hhautomatizacion/sec-challenge/README.md

<br/>
<p align="center">
  
</p>
<br/>

# sec-challenge

## Fecha
* 2014

## Descripcion del proyecto
* Control de secadora industrial challenge

## Herramientas utilizadas
* KGL_WIN version 3.66
* DopSoft version 1.01.08

## Modelos PLC, etc
* PLC LS Master K 120S K7M-DR40U
* HMI Delta DOP B05S111
* Modulo Analogo G7F-ADHA

## Autores
* <a href="http://www.github.com/emmanuel156">emmanuel156</a> 
* <a href="http://www.github.com/pedrohermon">pedrohermon</a> 

## Comentarios
* Ninguno

## Contenido
* Carpeta de Diagramas
	* Diagramas del proyecto
		* Diagramas electricos
		* Diagramas de bloques
		* Dibujos
* Carpeta de Documentos
	* Documentos pensados para el usuario final
		* Manuales de usuario
		* Manuales de programacion
* Carpeta de Fotos
	* Fotos del proyecto antes, durante y despues del desarrollo del mismo
		* Fotos
		* Capturas de pantalla
* Carpeta de Historial
	* Documentacion del desarrollo del proyecto
		* Hojas de datos de componentes
		* Manuales de usuario de componentes
		* Documentacion de funciones, herramientas
* Carpeta de Programas
	* Programas de Computadora, PLC, etc. 
		* Codigos fuente
		* Iconos e imagenes usados en los programas
		* Archivos de configuracion de los programas
		* Programas compilados
* Carpeta de Pruebas
	* Pruebas preliminares del proyecto
		* Programas incompletos, o secciones de programas
		* Capturas de comunicacion
		* Modelos de componentes que se hayan probado

---
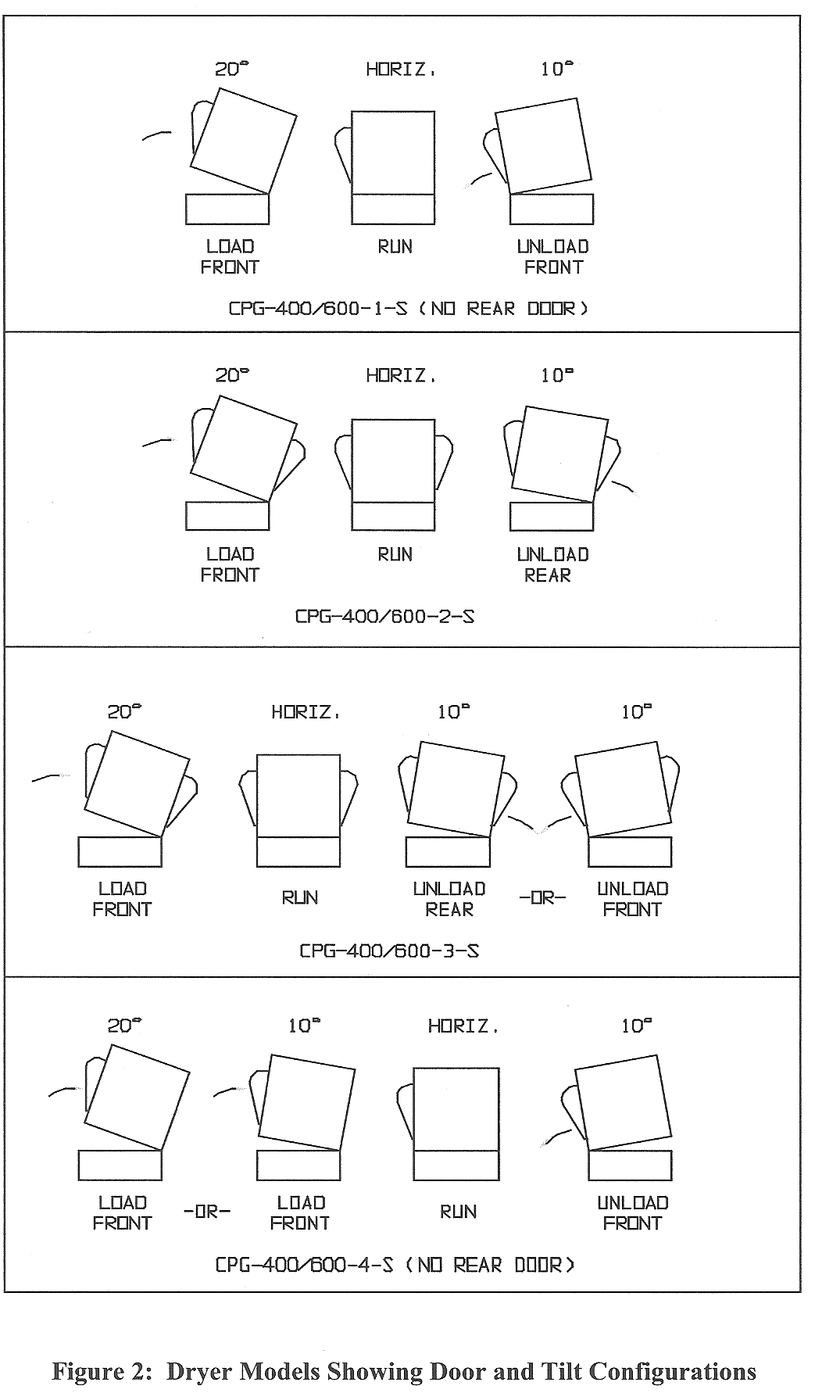
[picture p1: Diagramas/posiciones secadora.png]
posiciones secadora.png

---
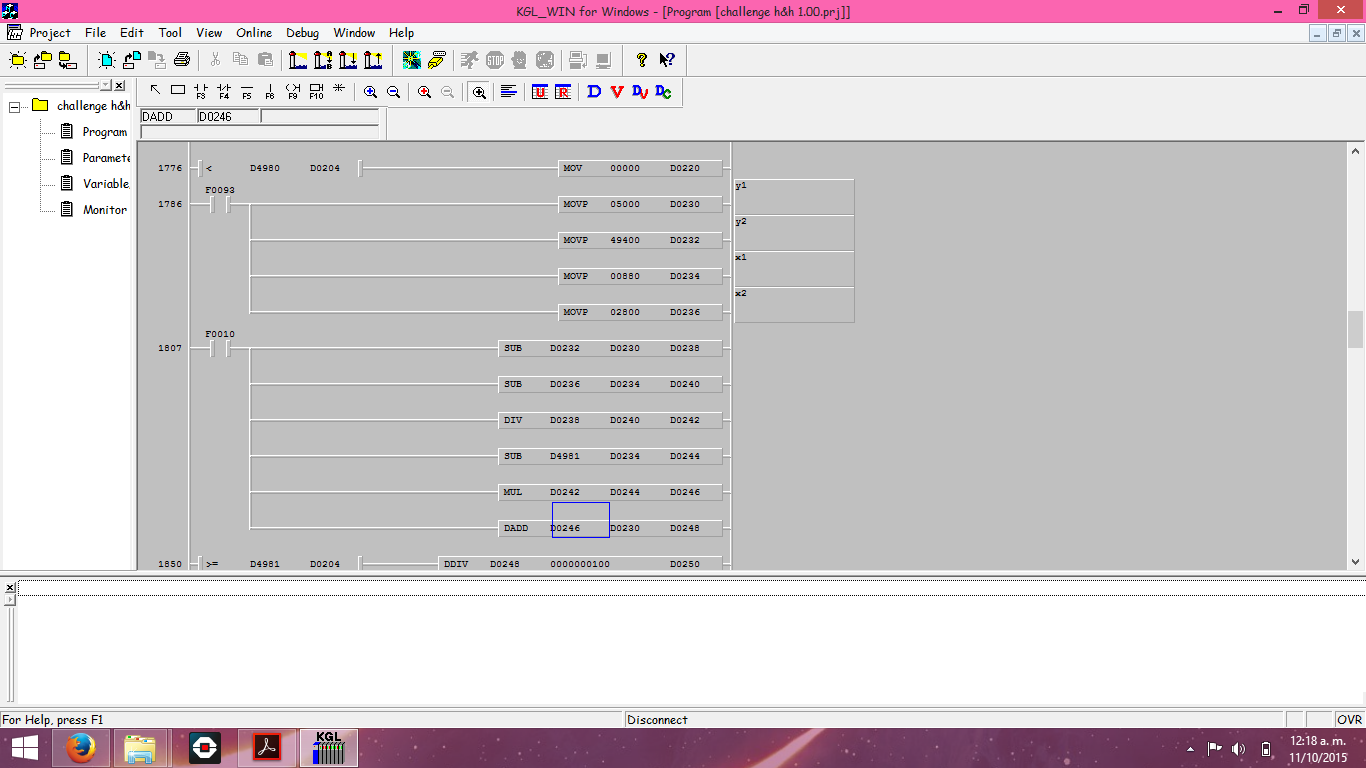
[picture p2: Fotos/Captura de pantalla 2015-10-11 00.18.39.png]
Captura de pantalla 2015-10-11 00.18.39.png

---
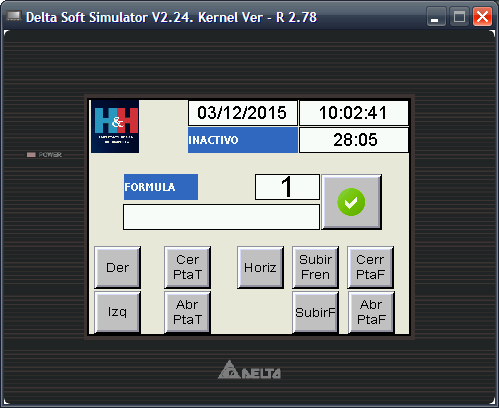
[picture p3: Fotos/Captura de pantalla 2015-12-03 10.02.41.png]
Captura de pantalla 2015-12-03 10.02.41.png

---
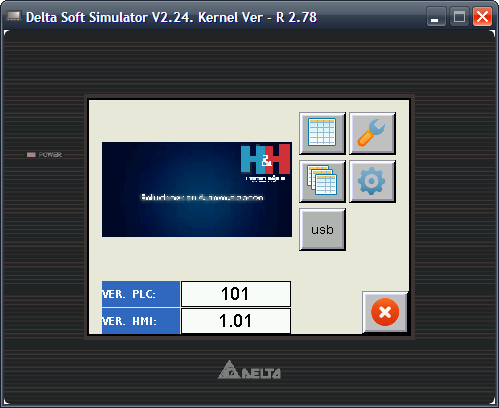
[picture p4: Fotos/Captura de pantalla 2015-12-03 14.47.43.png]
Captura de pantalla 2015-12-03 14.47.43.png

---
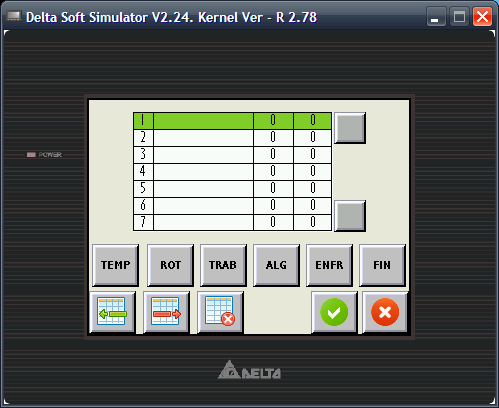
[picture p5: Fotos/Captura de pantalla 2015-12-03 14.53.48.png]
Captura de pantalla 2015-12-03 14.53.48.png

---
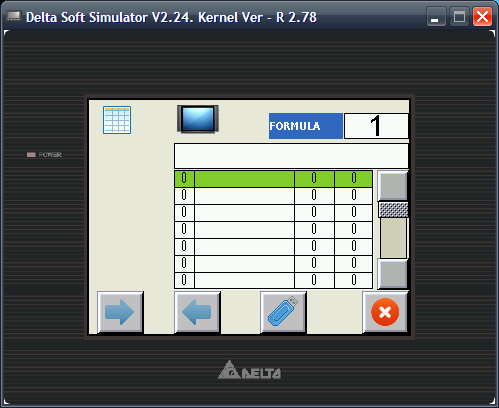
[picture p6: Fotos/Captura de pantalla 2015-12-03 14.54.10.png]
Captura de pantalla 2015-12-03 14.54.10.png

---
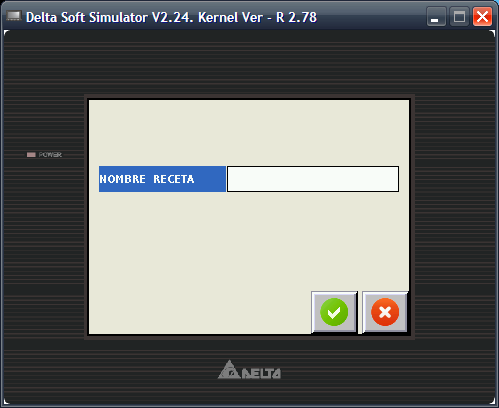
[picture p7: Fotos/Captura de pantalla 2015-12-03 14.54.32.png]
Captura de pantalla 2015-12-03 14.54.32.png

---
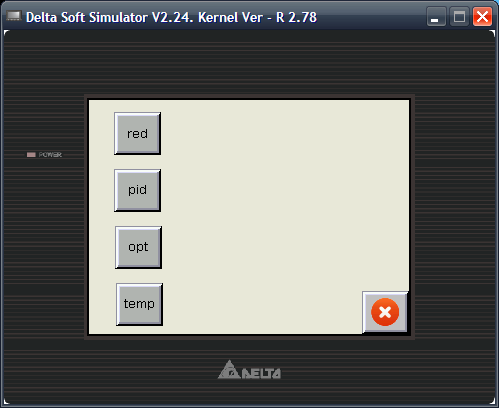
[picture p8: Fotos/Captura de pantalla 2015-12-03 14.55.09.png]
Captura de pantalla 2015-12-03 14.55.09.png

---
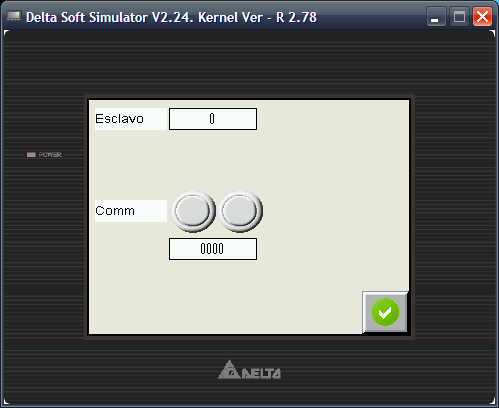
[picture p9: Fotos/Captura de pantalla 2015-12-03 14.55.13.png]
Captura de pantalla 2015-12-03 14.55.13.png

---
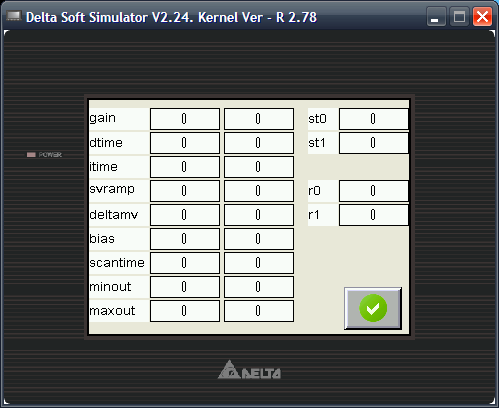
[picture p10: Fotos/Captura de pantalla 2015-12-03 14.55.18.png]
Captura de pantalla 2015-12-03 14.55.18.png

---
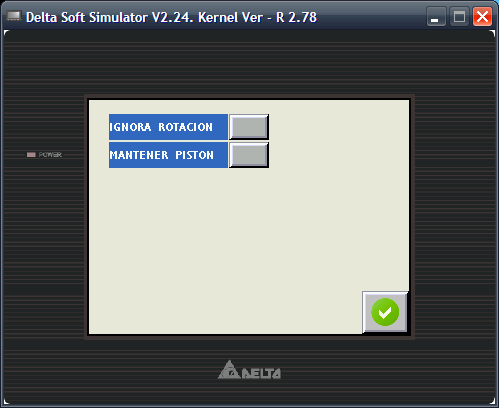
[picture p11: Fotos/Captura de pantalla 2015-12-03 14.55.22.png]
Captura de pantalla 2015-12-03 14.55.22.png

---
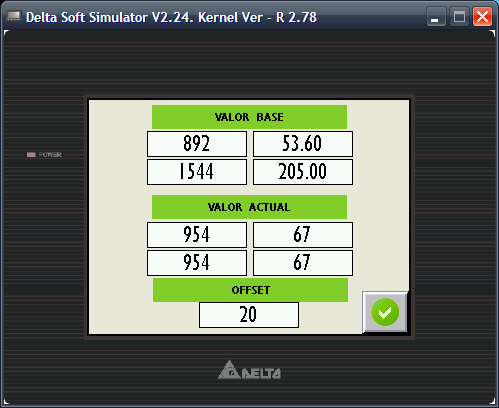
[picture p12: Fotos/Captura de pantalla 2015-12-03 14.57.56.png]
Captura de pantalla 2015-12-03 14.57.56.png

---
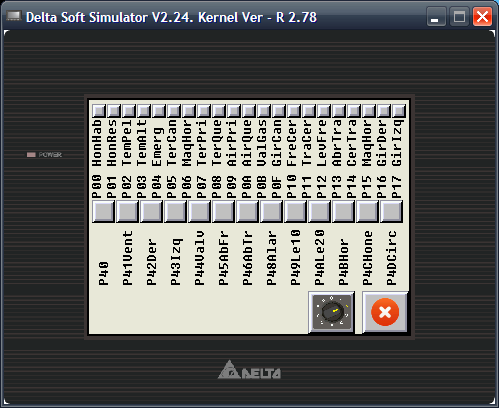
[picture p13: Fotos/Captura de pantalla 2015-12-03 14.58.13.png]
Captura de pantalla 2015-12-03 14.58.13.png

---
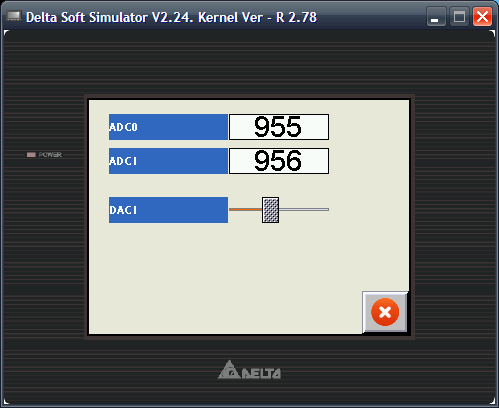
[picture p14: Fotos/Captura de pantalla 2015-12-03 14.58.29.png]
Captura de pantalla 2015-12-03 14.58.29.png

---
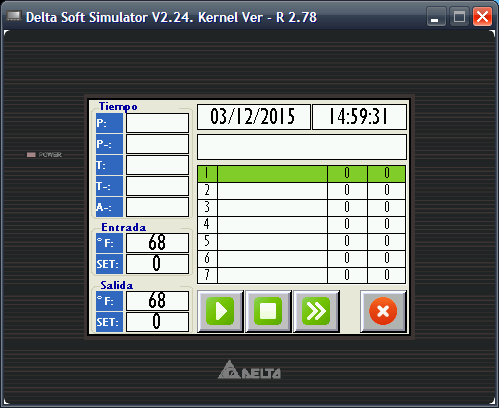
[picture p15: Fotos/Captura de pantalla 2015-12-03 14.59.31.png]
Captura de pantalla 2015-12-03 14.59.31.png

---
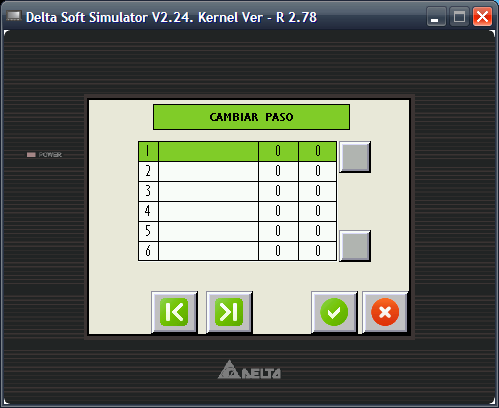
[picture p16: Fotos/Captura de pantalla 2015-12-03 14.59.51.png]
Captura de pantalla 2015-12-03 14.59.51.png

---
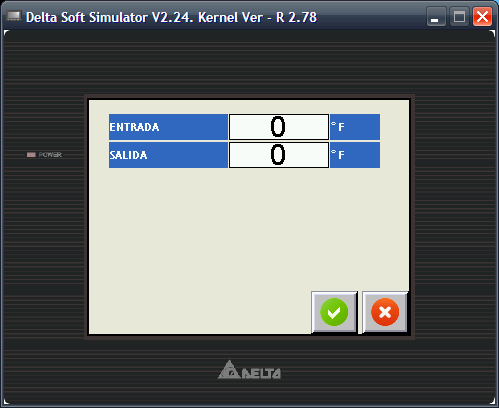
[picture p17: Fotos/Captura de pantalla 2015-12-03 15.03.30.png]
Captura de pantalla 2015-12-03 15.03.30.png

---
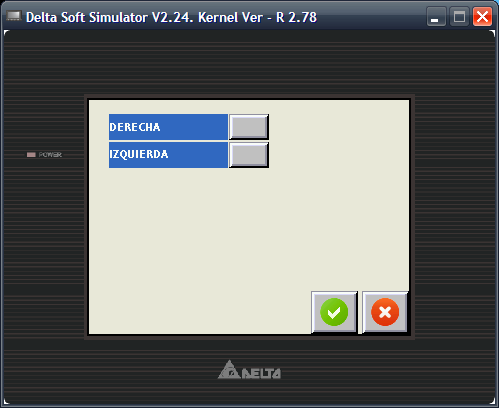
[picture p18: Fotos/Captura de pantalla 2015-12-03 15.03.36.png]
Captura de pantalla 2015-12-03 15.03.36.png

---
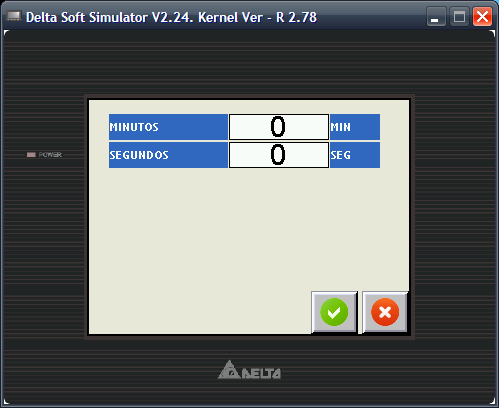
[picture p19: Fotos/Captura de pantalla 2015-12-03 15.03.47.png]
Captura de pantalla 2015-12-03 15.03.47.png

---
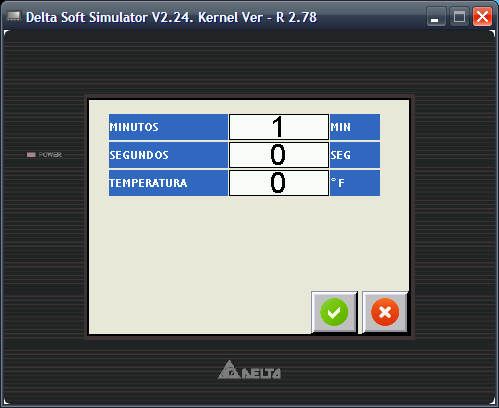
[picture p20: Fotos/Captura de pantalla 2015-12-03 15.04.00.png]
Captura de pantalla 2015-12-03 15.04.00.png

---
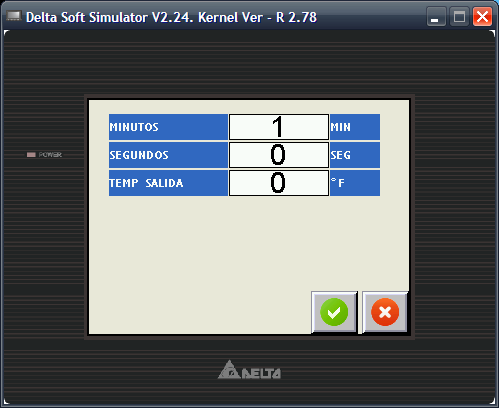
[picture p21: Fotos/Captura de pantalla 2015-12-03 15.04.10.png]
Captura de pantalla 2015-12-03 15.04.10.png

---
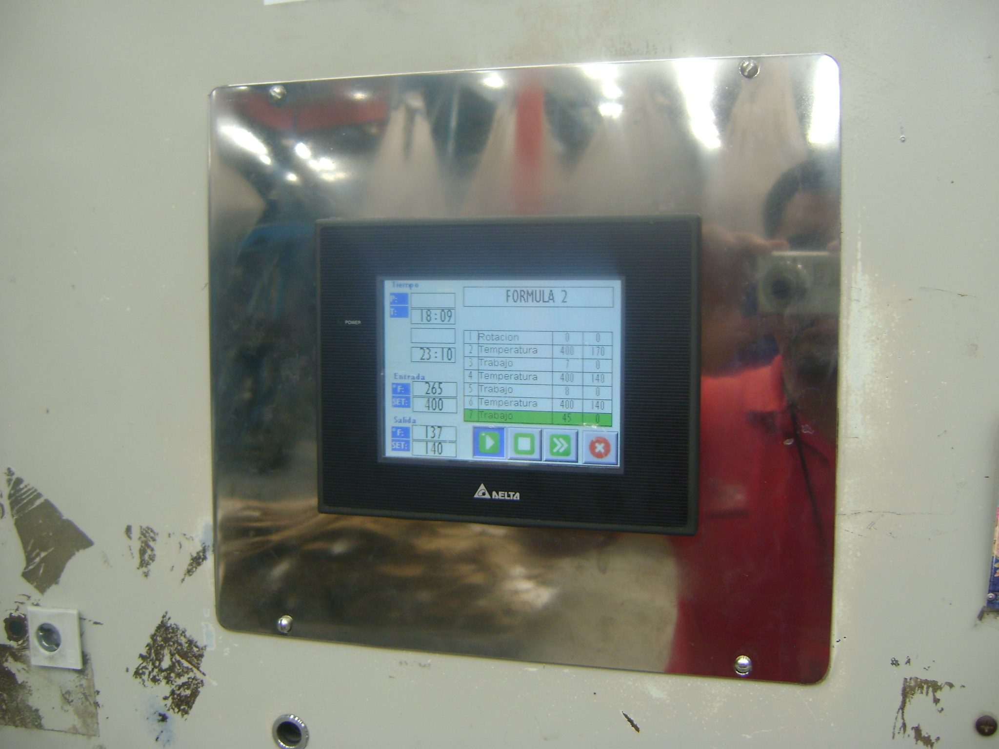
[picture p22: Fotos/DSC03655.JPG]

---
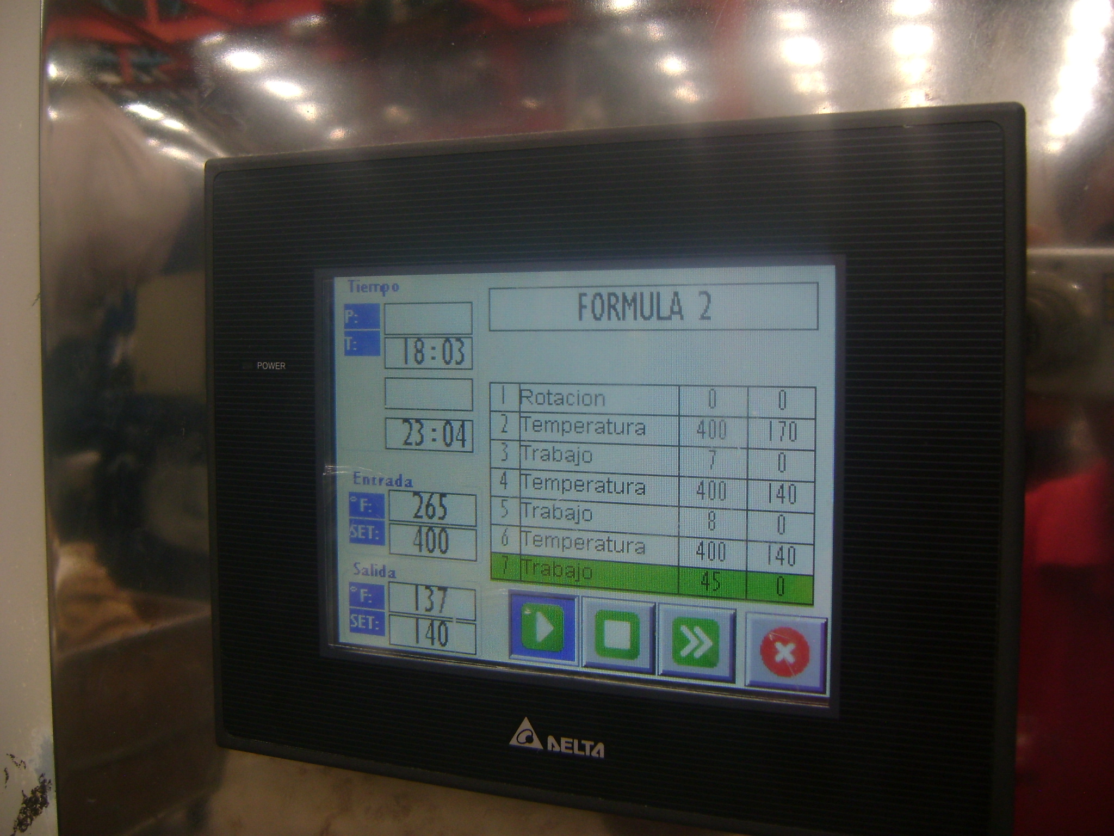
[picture p23: Fotos/DSC03656.JPG]

---
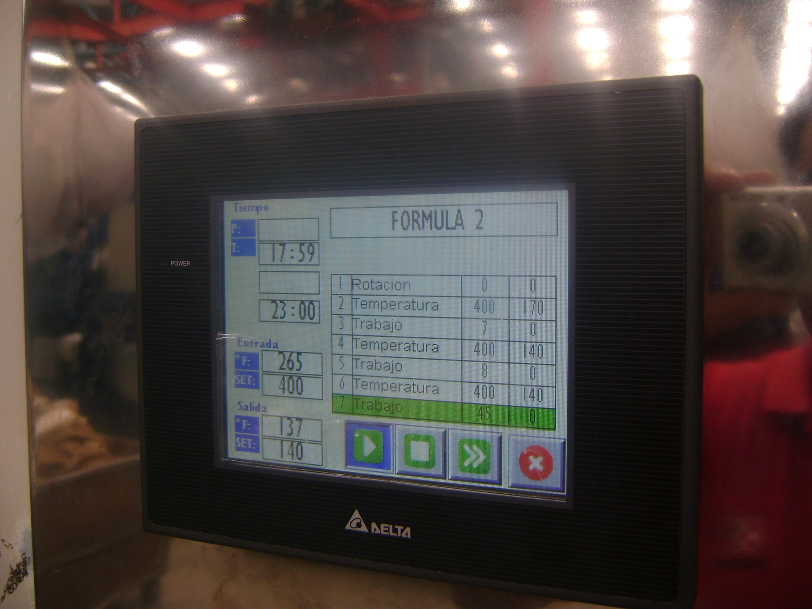
[picture p24: Fotos/DSC03657.JPG]

---
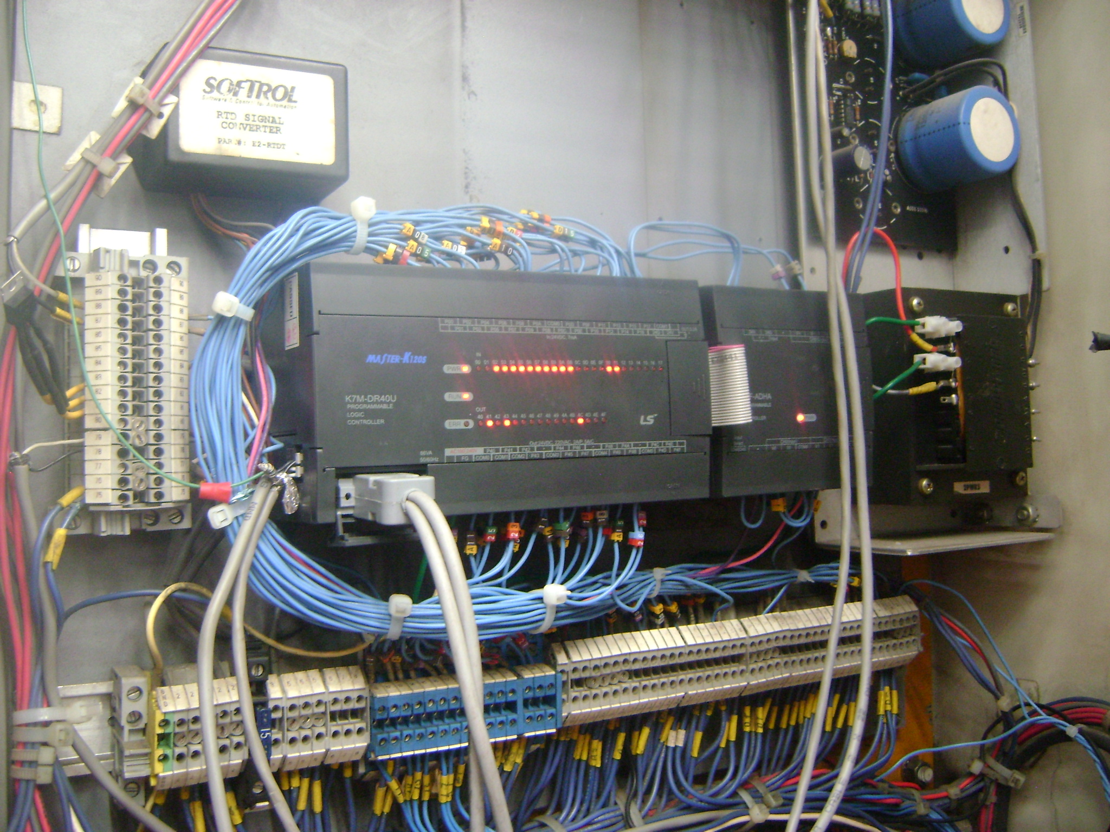
[picture p25: Fotos/DSC03658.JPG]

---
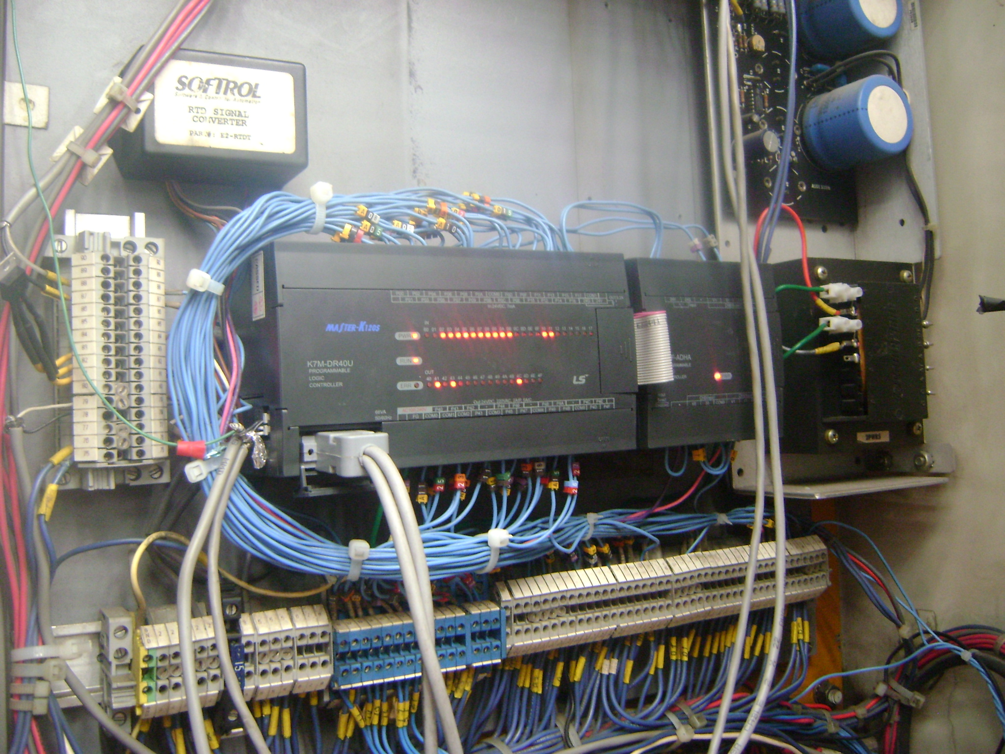
[picture p26: Fotos/DSC03659.JPG]

---
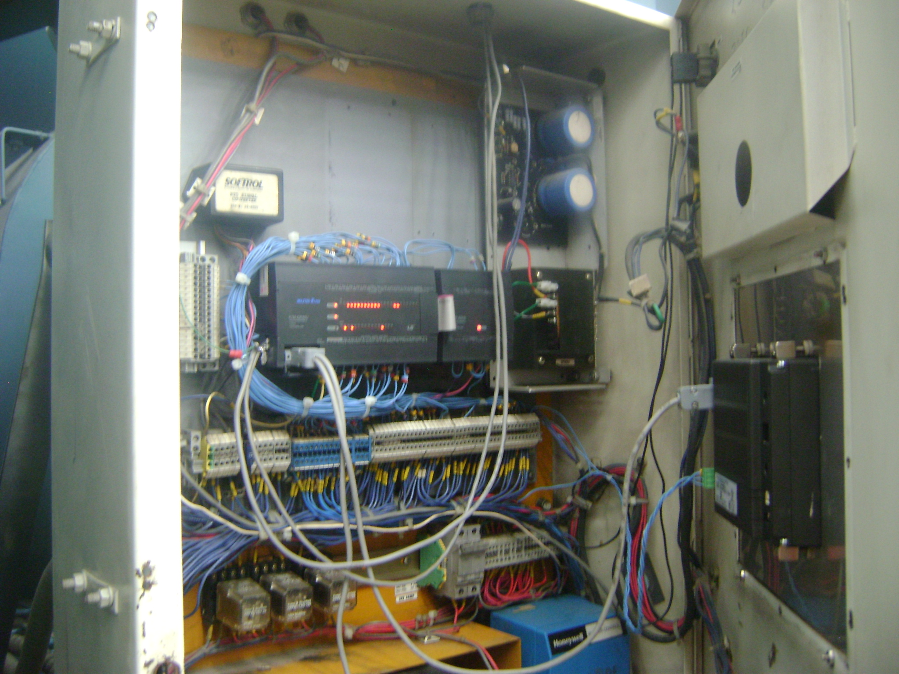
[picture p27: Fotos/DSC03660.JPG]

---

---
-10.ico
---
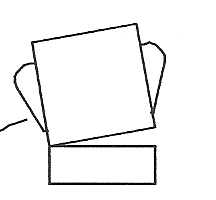
[picture p29: Programas/iconos v3/-10.png]

---
0.ico
---
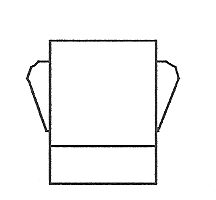
[picture p30: Programas/iconos v3/0.png]

---
10.ico
---
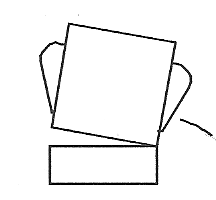
[picture p31: Programas/iconos v3/10.png]

---
20.ico
---
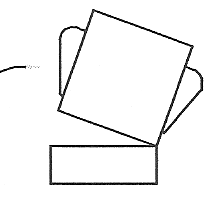
[picture p32: Programas/iconos v3/20.png]

---
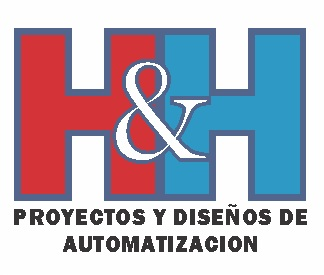
[picture p33: Programas/iconos v3/LOGO2.png]

---

---

---

---

---

---

---

---

---

---

---

---

---

---

---

---

---

---

---

---

---

---

---

---

---

---

---

---

---

---

---

---

---

---

---

---
PF.ico
---

---
PT.ico
---

---
arrow_left.ico
---

---
arrow_right.ico
---

---
backward.ico
---
check.ico
---

---
close.ico
---

---
config.ico
---

---
delete_row.ico
---

---
edit.ico
---

---
flashdisk.ico
---

---
forward.ico
---

---
insert_row.ico
---

---
network.ico
---

---
next.ico
---

---
pause.ico
---
pendrive.ico
---
play.ico
---

---
previous.ico
---
screen.ico
---
spin_left.ico
---
spin_right.ico
---
stop.ico
---

---
table.ico
---

---
table_edit.ico
---

---
table_erase.ico
---

---
table_multiple.ico
---

---
test.ico
---

---
