hhautomatizacion/sec-challenge/Diagramas/README.md

<br/>
<p align="center">
  
</p>
<br/>

# Carpeta de Diagramas

## Diagramas del proyecto

* Diagramas electricos

* Diagramas de bloques

* Dibujos

---
posiciones secadora.png
---
