hhautomatizacion/sec-challenge/Programas/dop-b07s411/notas.txt

No editar!

Editar la version de dop-b05s111 y convertir desde ahi. Aumentar el tamaño de texto de los grid a 22 pixeles.
