hhautomatizacion/sec-challenge/Diagramas/entradas y salidas.xlsx

P00 HonHab | HONEYWELL NO HABILITADO | P40
P01 HonRes | HONEYWELL NECESITA RESET | P41 Vent | ARRANQUE VENTILADORES
P02 TemPel | TEMPERATURA PELUCERO OK | P42 Der | TOMBOLA GIRO DERECHO
P03 TemAlt | LIMITE DE TEMPERATURA ALTO | P43 Izq | TOMBOLA GIRO IZQUIERDO
P04 Emerg | PUERTA VENT. PPAL. CERRADO / PARO EMERGENCIA | P44 Valv | ACTIVACION VALVULAS
P05 TerCan | SOBRE CARGA CANASTA | P45 AbFr | ABRIR PUERTA FRONTAL
P06 MaqHor | SENSOR MAQUINA HORIZONTAL | P46 AbTr | ABRIR PUETRA TRASERA
P07 TerPri | SOBRE CARGA VENT. PPAL. | P48 Alar | ALARMA SONORA
P08 TerQue | SOBRE CARGA VENT. QUEMADOR | P49 Le10 | LEVANTA FRENTE 10°
P09 AirPri | PUERTAS ABIERTAS / INT. AIRE VENT. PPAL. | P4A Le20 | LEVANTA FRENTE 20°
P0A AirQue | INT. AIRE QUEMADOR | P4B Hor | BAJA FRENTE
P0B ValGas | VALV. COMBUSTIBLE ON | P4C HaHo | HABILITACION HONEYWELL
P0F GirCan | SENSOR GIRO DE CANASTA | P4D Rcir | COMPUERTA RECIRCULACION
P10 FreCer | PUERTA FRONTAL CERRADA
P11 TraCer | PUERTA TRASERA CERRADA
P12 LevFre | LEVANTAR FRENTE (MANDO POSTERIOR)
P13 AbrTra | ABRIR PUERTA TRASERA (MANDO POSTERIOR)
P14 CerTra | CERRAR PUERTA TRASERA (MANDO POSTERIOR)
P15 MaqHor | MAQUINA HORIZONTAL (MANDO POSTERIOR)
P16 GirDer | GIRAR CANASTA DERECHA (CONTROL COLGANTE)
P17 GirIzq | GIRAR CANASTA IZQUIERDA (CONTROL COLGANTE)
