hhautomatizacion/sec-challenge/(list of files, cad)

Other CAD files:
Diagramas/sensor humedad.dwg
Diagramas/Modificacion secadora CHALLENGE.dwg
