hhautomatizacion/sec-challenge/Pruebas/texto.xlsx

Sheet: HEX
 | 41 | 6c | 67 | 3d
 | 41
 | 1 | 2 | 3 | 4 | 5 | 6 | 7 | 8 | 9 | 10
DEC | 65 | 108 | 103 | 61 | 0 | 0 | 0 | 0 | 0 | 0
TEXTO | A | l | g | = | #VALUE! | #VALUE! | #VALUE! | #VALUE! | #VALUE! | #VALUE!

Sheet: TEXTO
 | RH=
 | RH=
 | 1 | 2 | 3 | 4 | 5 | 6 | 7 | 8 | 9 | 10
CAR |  | R | H | =
DEC | 32 | 82 | 72 | 61 | 32 | 32 | 32 | 32 | 32 | 32
HEX | 20 | 52 | 48 | 3D | 20 | 20 | 20 | 20 | 20 | 20
DECWORD | 21024 |  | 15688 |  | 8224 |  | 8224 |  | 8224
HEXWORD | 5220 |  | 3D48 |  | 2020 |  | 2020 |  | 2020
