hhautomatizacion/sec-challenge/Pruebas/conversion adc.xlsx

 | adc | °c | °F
 | 1544 | 205 | 95 |  |  | 1544 | 2050000 | 10000
 | 892 | 53.6 | 12 |  |  | 892 | 536000
 |  |  |  |  |  | 2204
 | 2204 | 358.2576687 |  | sub | 2050000 | 536000 | 1514000
 |  |  |  | sub | 1544 | 892 | 652
 |  |  |  | div | 1514000 | 652 | 2322
 |  |  |  | sub | 2204 | 892 | 1312
 |  |  |  | mul | 2322 | 1312 | 3046464
 |  |  |  | add | 3046464 | 536000 | 3582464
798 |  |  |  |  |  |  | 358
