hhautomatizacion/sec-challenge/Pruebas/sec 17 2015-03-20 16.55.17.xlsx

Sheet: H0001
16:55:17 | 03/20/2015 | 3 | 5 | 1 | 123 | 110 | 180 | 400 | 25 | 2000 | 2200 | 1300 | 0 | 0 | 0 | 0 | 0
16:55:35 | 03/20/2015 | 3 | 5 | 19 | 122 | 110 | 180 | 400 | 25 | 2000 | 2200 | 1300 | 0 | 0 | 0 | 0 | 0
16:55:37 | 03/20/2015 | 3 | 5 | 21 | 123 | 110 | 180 | 400 | 25 | 2000 | 2200 | 1300 | 0 | 0 | 0 | 0 | 0
16:55:39 | 03/20/2015 | 3 | 5 | 23 | 123 | 110 | 180 | 400 | 25 | 2000 | 2200 | 1300 | 0 | 0 | 0 | 0 | 0
16:55:41 | 03/20/2015 | 3 | 5 | 25 | 122 | 110 | 180 | 400 | 25 | 2000 | 2200 | 1300 | 0 | 0 | 0 | 0 | 0
16:55:43 | 03/20/2015 | 3 | 5 | 27 | 122 | 110 | 180 | 400 | 25 | 2000 | 2200 | 1300 | 0 | 0 | 0 | 0 | 0
16:55:45 | 03/20/2015 | 3 | 5 | 29 | 122 | 110 | 180 | 400 | 25 | 2000 | 2200 | 1300 | 0 | 0 | 0 | 0 | 0
16:55:47 | 03/20/2015 | 3 | 5 | 31 | 123 | 110 | 180 | 400 | 25 | 2000 | 2200 | 1300 | 0 | 0 | 0 | 0 | 0
16:55:49 | 03/20/2015 | 3 | 5 | 33 | 123 | 110 | 180 | 400 | 25 | 2000 | 2200 | 1300 | 0 | 0 | 0 | 0 | 0
16:55:51 | 03/20/2015 | 3 | 5 | 35 | 123 | 109 | 180 | 400 | 25 | 2000 | 2200 | 1300 | 0 | 0 | 0 | 0 | 0
16:55:53 | 03/20/2015 | 3 | 5 | 37 | 124 | 110 | 180 | 400 | 25 | 2000 | 2200 | 1300 | 0 | 0 | 0 | 0 | 0
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
