hhautomatizacion/sec-challenge/Pruebas/SEC 17 2015-03-22 14.38.17.xlsx

Sheet: H0001
14:38:17 | 03/22/2015 | 3 | 5 | 1 | 94 | 87 | 198 | 400 | 0 | 25 | 3000 | 2200 | 2500 | 0 | 0 | 0 | 0
14:38:19 | 03/22/2015 | 3 | 5 | 3 | 94 | 87 | 198 | 400 | 0 | 25 | 3000 | 2200 | 2500 | 0 | 0 | 0 | 0
14:38:21 | 03/22/2015 | 3 | 5 | 5 | 94 | 87 | 198 | 400 | 0 | 25 | 3000 | 2200 | 2500 | 0 | 0 | 0 | 0
14:38:23 | 03/22/2015 | 3 | 5 | 7 | 94 | 87 | 198 | 400 | 0 | 25 | 3000 | 2200 | 2500 | 0 | 0 | 0 | 0
14:38:25 | 03/22/2015 | 3 | 5 | 9 | 94 | 87 | 198 | 400 | 0 | 25 | 3000 | 2200 | 2500 | 0 | 0 | 0 | 0
14:38:27 | 03/22/2015 | 3 | 5 | 11 | 94 | 88 | 198 | 400 | 0 | 25 | 3000 | 2200 | 2500 | 0 | 0 | 0 | 0
14:38:29 | 03/22/2015 | 3 | 5 | 13 | 94 | 88 | 198 | 400 | 0 | 25 | 3000 | 2200 | 2500 | 0 | 0 | 0 | 0
14:38:31 | 03/22/2015 | 3 | 5 | 15 | 94 | 88 | 198 | 400 | 0 | 25 | 3000 | 2200 | 2500 | 0 | 0 | 0 | 0
14:38:33 | 03/22/2015 | 3 | 5 | 17 | 94 | 88 | 198 | 400 | 0 | 25 | 3000 | 2200 | 2500 | 0 | 0 | 0 | 0
14:38:35 | 03/22/2015 | 3 | 5 | 19 | 94 | 88 | 198 | 400 | 0 | 25 | 3000 | 2200 | 2500 | 0 | 0 | 0 | 0
14:38:37 | 03/22/2015 | 3 | 5 | 21 | 94 | 89 | 198 | 400 | 0 | 25 | 3000 | 2200 | 2500 | 0 | 0 | 0 | 0
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
