hhautomatizacion/sec-challenge/(threads)

Thread 3 (2015-11-29):

Corregir error donde no toma en cuenta entrada de limite de temperatura.

emmcasher, 2015-11-29:

Closed 2015-11-30.
