hhautomatizacion/sec-challenge/Diagramas/Diagrama modificacion Challenge.pdf

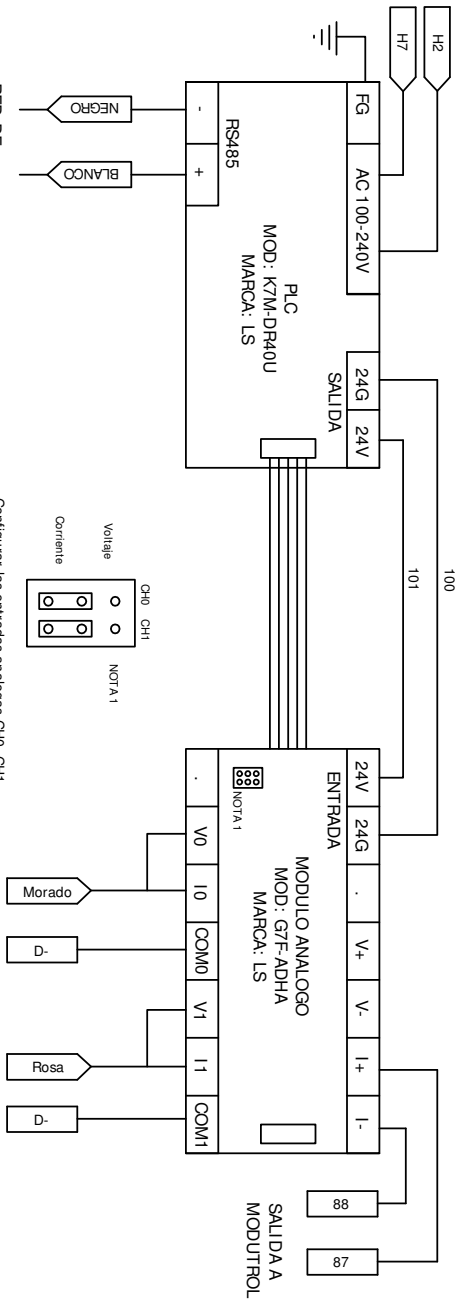
[picture p51: figure]
MODUTROL; SALIDA A; Morado; Rosa; NOTA 1; Corriente; Voltaje

V0 I0 COM0 V1 I1 . COM1 MOD: G7F-ADHA MARCA: LS MODULO ANALOGO MOD: K7M-DR40U MARCA: LS PLC 24G 24V ENTRADA SALIDA RS485 +

## DE ENTRADA TEMPERATURA

## DE SALIDA TEMPERATURA

RS485

## COMUNICACION

## RED DE

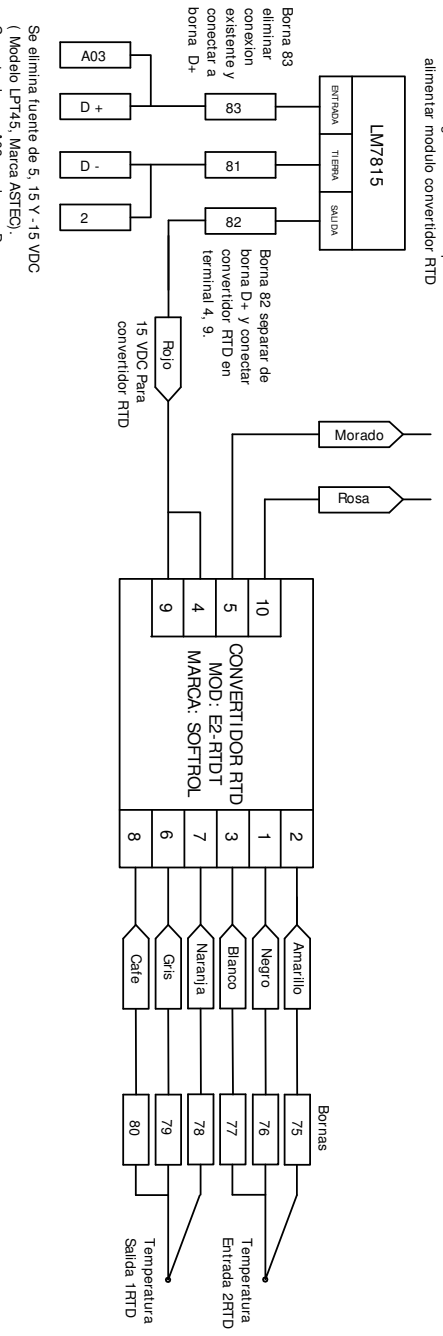
[picture p52: figure]
borna D+; conectar a; existente y; conexion; eliminar; Borna 83; ENTRADA TI ERRA SALI DA; MOD: E2-RTDT; MARCA: SOFTROL; CONVERTIDOR RTD; Rosa; Morado; convertidor RTD; 15 VDC Para 80; Bornas; Negro; Blanco; Amarillo; Gris; Naranja; Cafe; Salida 1RTD; Temperatura; Entrada 2RTD; terminal 4, 9.; convertidor RTD en; borna D+ y conectar; Borna 82 separar de; alimentar modulo convertidor RTD; ( Modelo LPT45, Marca ASTEC).; Se elimina fuente de 5, 15 Y -15 VDC; Rojo

Instalar regulador de 15 VDC para

conectar borna 2 con borna D-.

Conectar borna A03 con borna D+ y

## MOD: DOP-B05S111 MARCA: DELTA

ELECTRONICS, INC.

## PANTALLA TACTIL + 24V

0V D -
A03

5
3

2

5

4
7

El presente es complemento del diagrama electrico o Modelo: CPG6-3X1L

Marca: CHALLENGE

Equipo: Secadora textil

EQUIPO:

riginal

Numero A- 7173817-(16) o (22) de secadora challenge.

Representa Borna de conexion.
Representa cable.

1 pza. Pantalla Tactil Marca: Delta electronics,inc

1 pza. Modulo analogo marca: Ls, Modelo: G7F-ADHA.

1 pza. PLC Marca: Ls, Modelo: K7M-DR40U
Lista de dispositivos instalados:

. modelo: DOP-B05S111

1 pza. Regulador de voltaje LM7815.
NOTAS:

Reemplazo de sistema de control OPTIMA XERIC ( soft

PROYECTO:

rol systems )

por PLC Marca: Ls y pantalla tactil Marca: Delta Electronics, inc.

1 pza. Consola Display y mandos de control OPTIMA X
Lista de dispositivos retirados:

ERIC

1 pza. Tablilla electronica marca: softrol systems, inc. modelo: MB8-8

1 pza. Tablilla electronica marca: softrol systems, inc. modelo: SPR-8031

1 pza. Tablilla electronica marca: softrol systems, inc. modelo: DCIP-16

1 pza. Tablilla electronica marca: softrol systems, inc. modelo: AI0-420

1 pza. Tablilla electronica marca: softrol systems, inc. modelo: ACI-16

1 pza. Tablilla electronica marca: softrol systems, inc. modelo: PRO-63Y

1 pza. Tablilla electronica marca: softrol systems, inc. modelo: REM-5T
2 pzas. Modulos de salidas marca: softrol systems, inc. modelo: IDR-8G4

1 pza. Fuente de alimentacion marca: astec, modelo: LPT45

En algunas maquinas en lugar de la borna (D -), aparece la borna (D0).

para corriente, como muestra la figura.
Configurar las entradas analogas CH0, CH1

# HONEYWELL NO HABILITADO A01

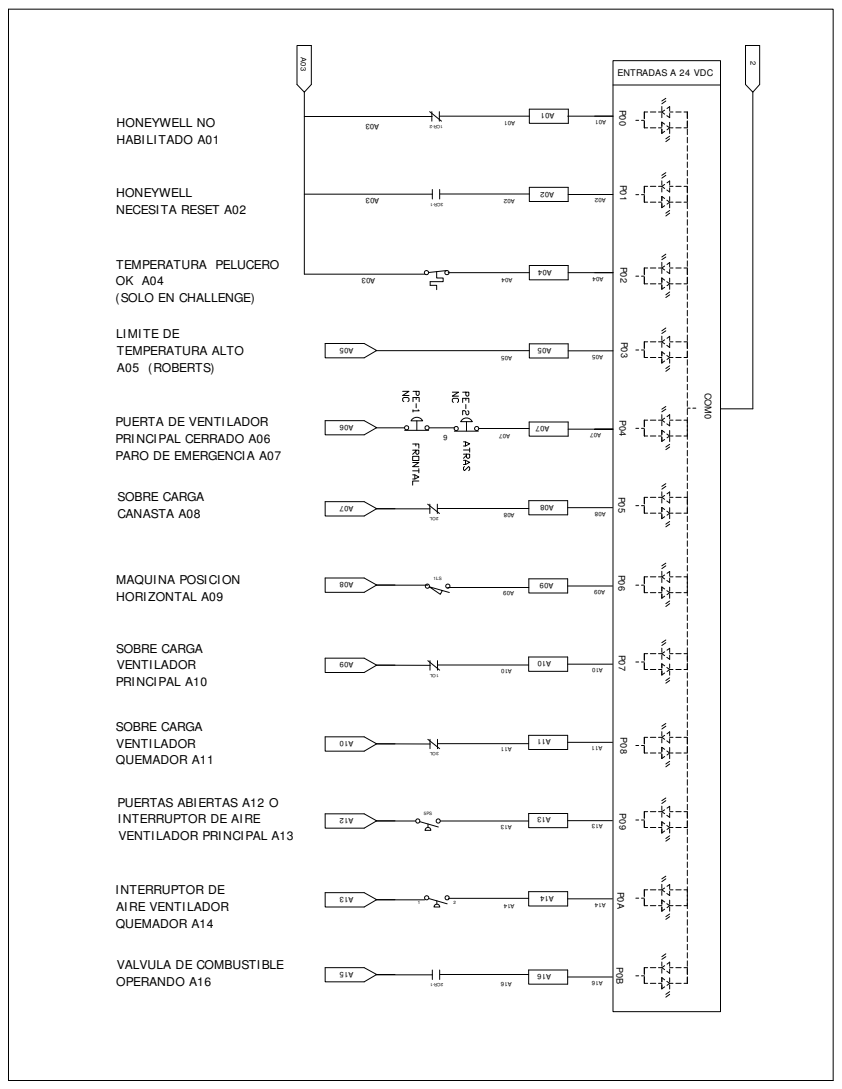
[picture p53: page 2]

PUERTA DE VENTI LADOR
PRI NCIPAL CERRADO A06
PARO DE EMERGENCIA A07

## ENTRADAS A 24 VDC

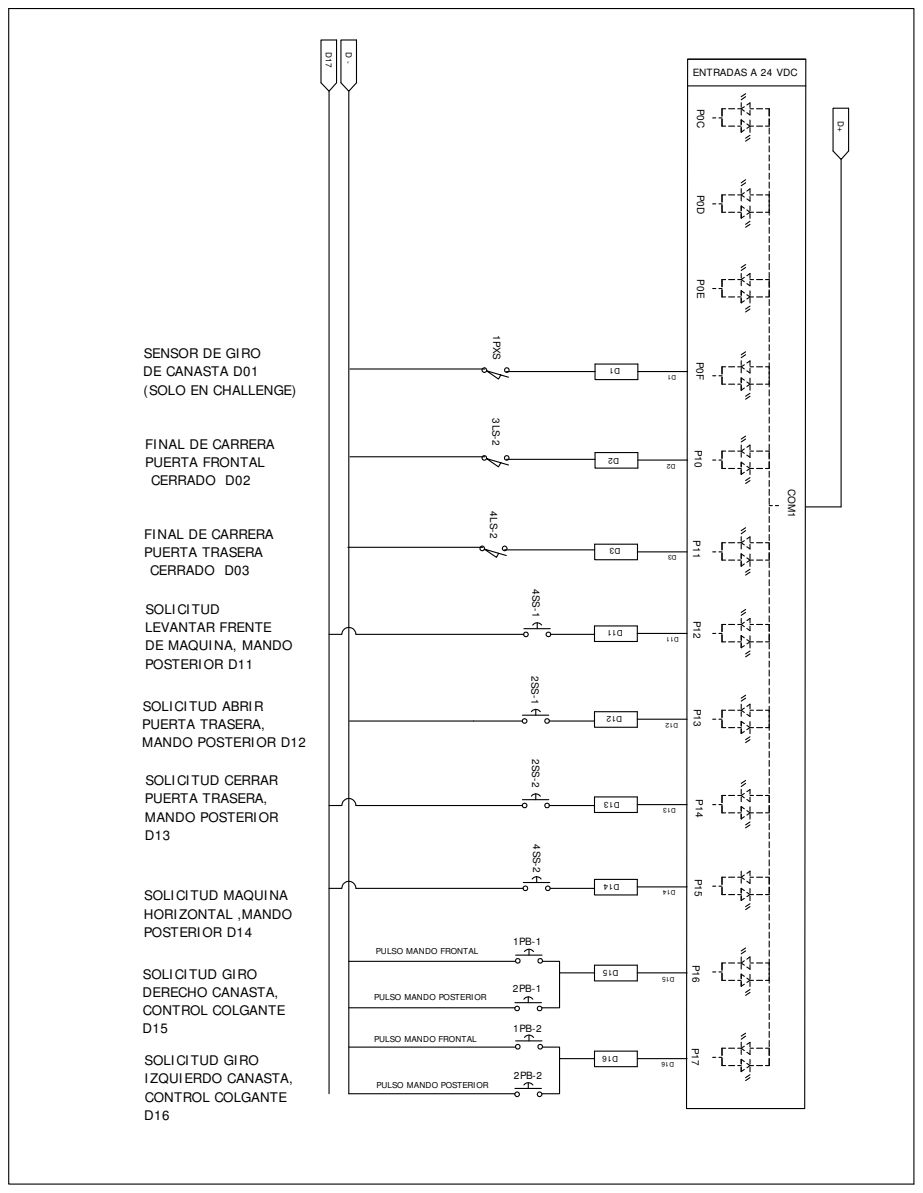
[picture p54: page 3]

SALIDAS RELEVADOR P4B P4A | COM4 COM0 COM1 P4C P4D P4F P4E | COM5

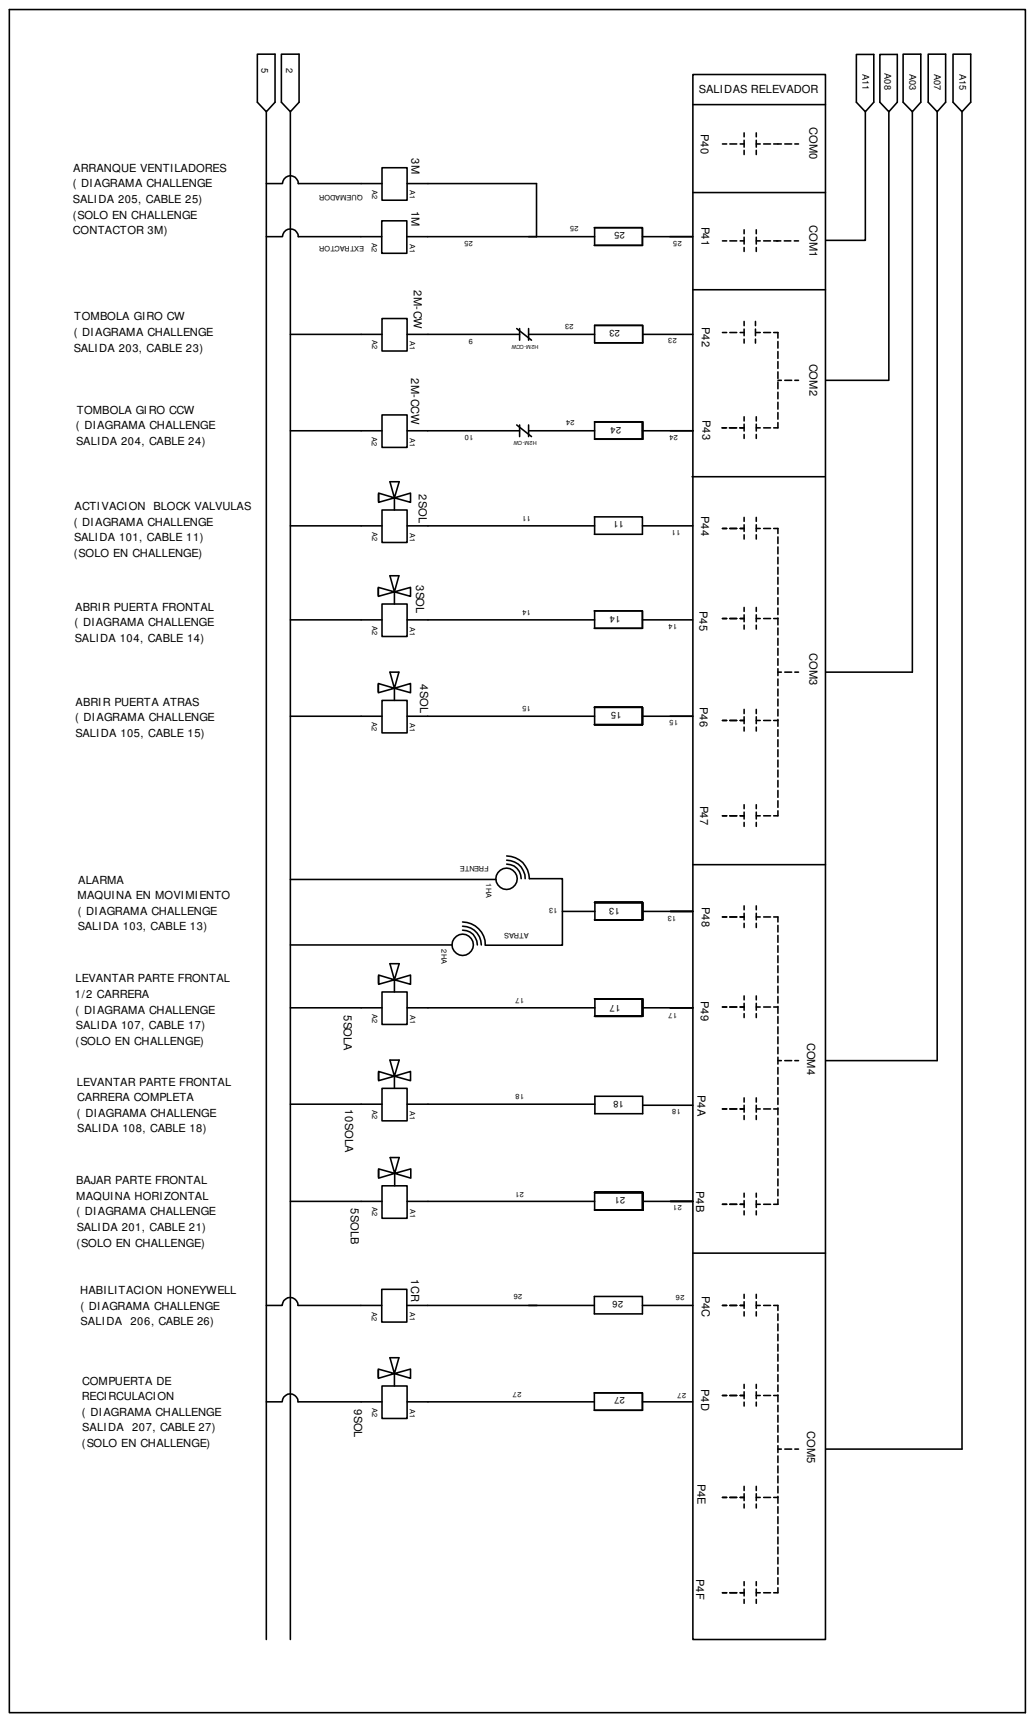
[picture p55: page 4]

TOMBOLA GI RO CCW
( DIAGRAMA CHALLENGE
SALIDA 204, CABLE 24)

ALARMA
MAQUI NA EN MOVIMIENTO
SALIDA 103, CABLE 13)

SALIDAS RELEVADOR P4B P4A | COM4 COM0 COM1 P4C P4D P4F P4E | COM5

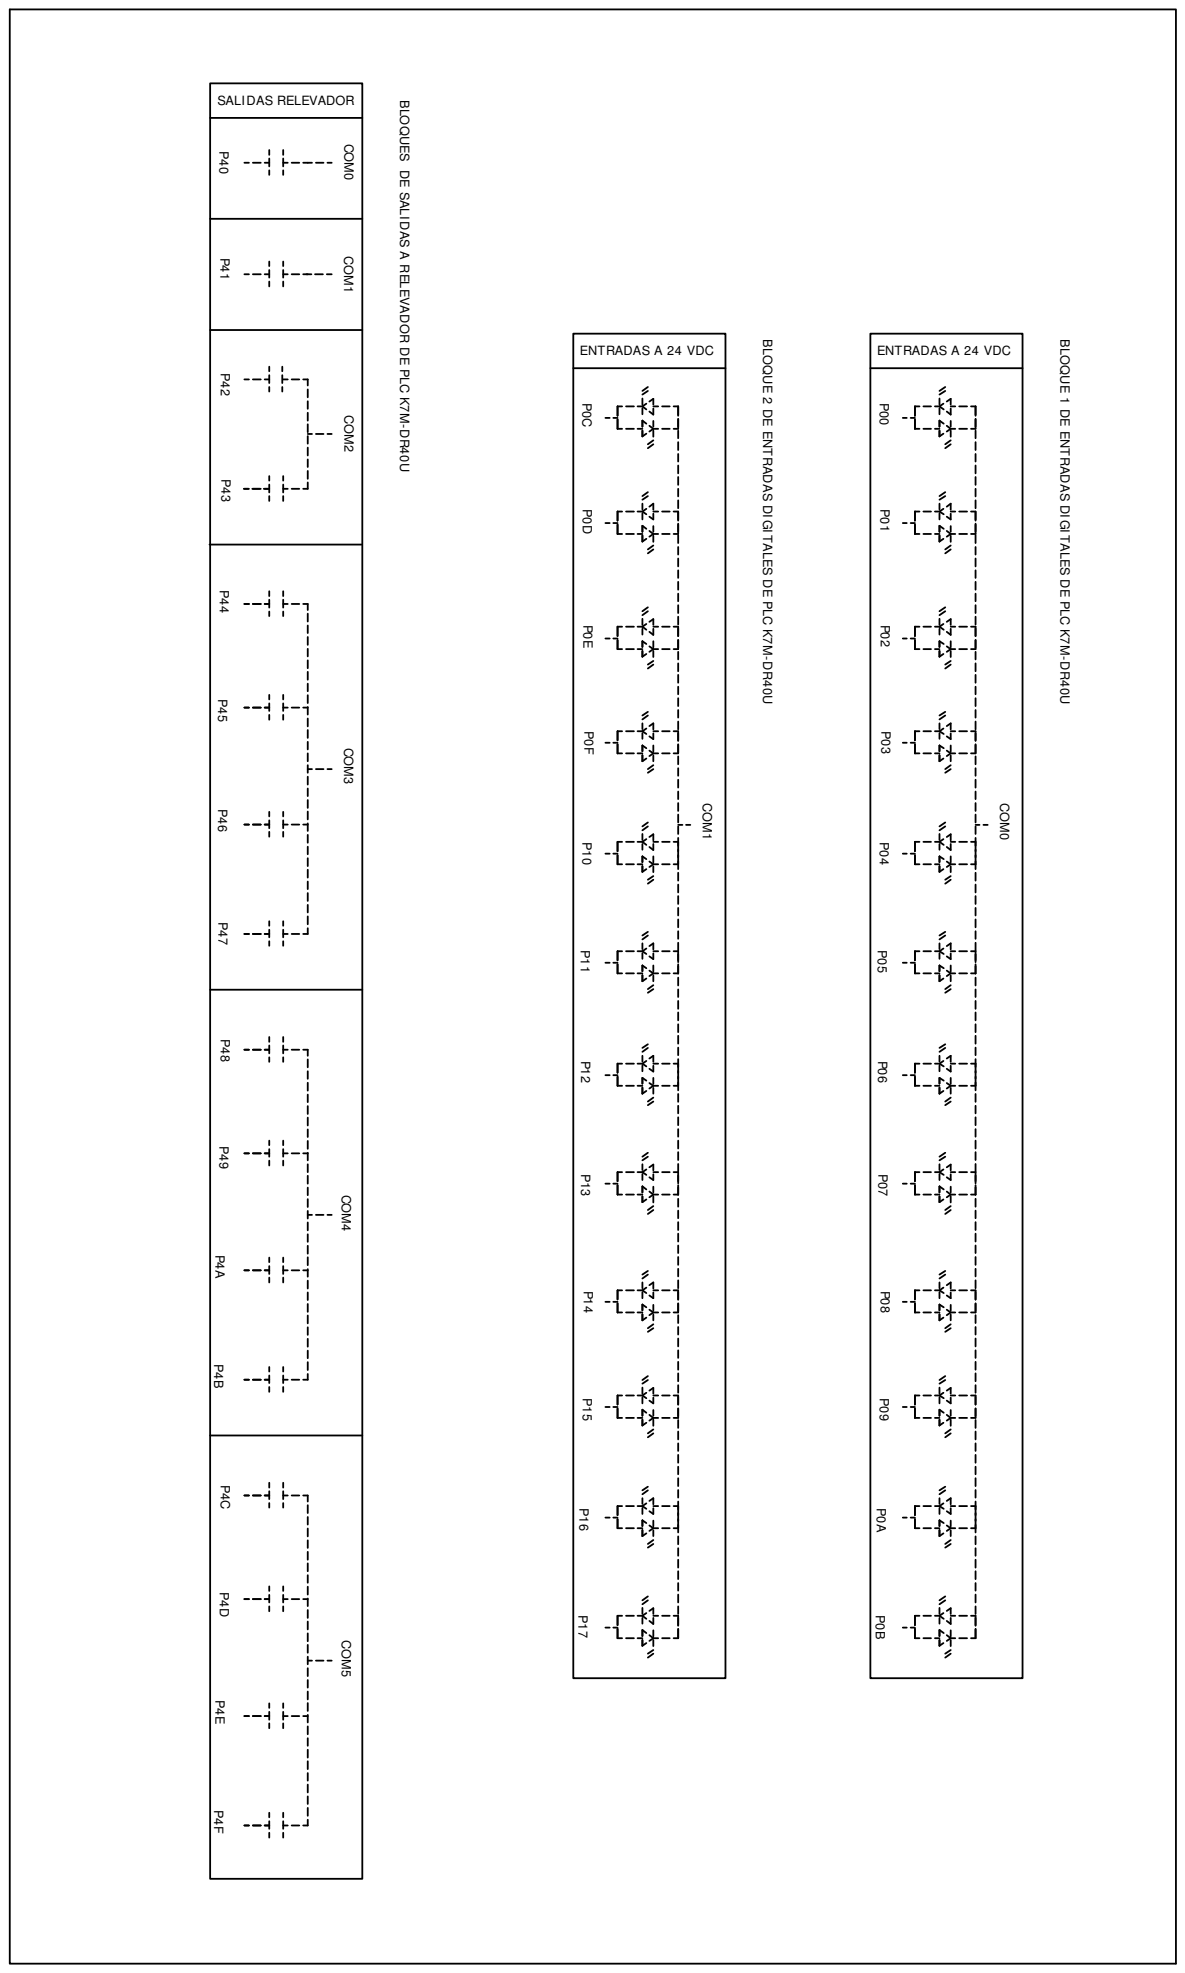
[picture p56: page 5]

BLOQUES DE SALIDAS A RELEVADOR DE PLC K7M-DR40U

BLOQUE 2 DE ENTRADAS DI GI TALES DE PLC K7M-DR40U

BLOQUE 1 DE ENTRADAS DI GI TALES DE PLC K7M-DR40U
