hhautomatizacion/sec-challenge/Diagramas/sensor humedad.pdf

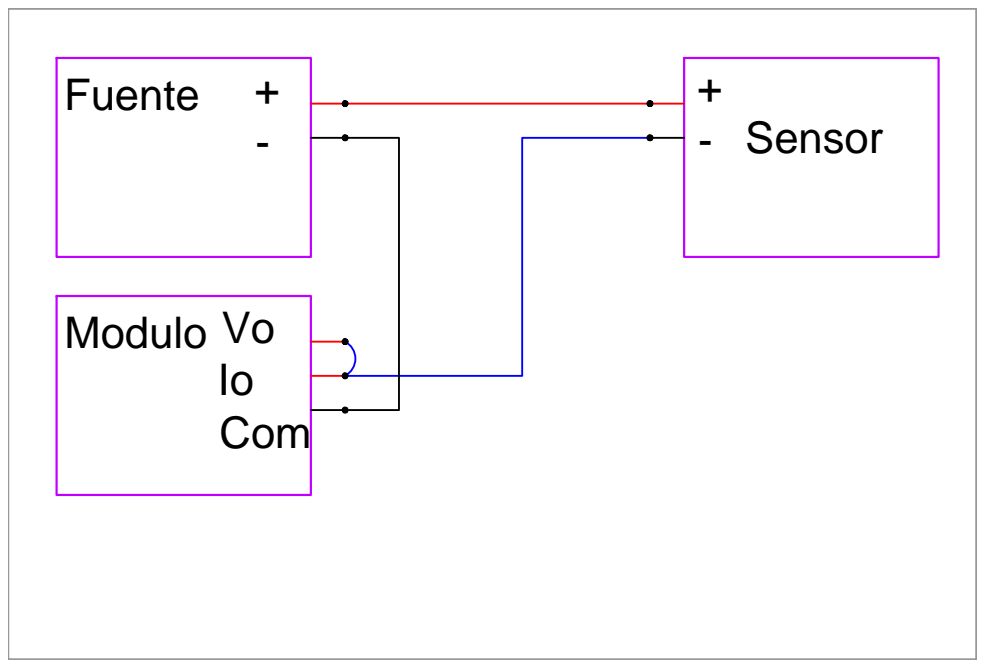
[picture p57: page 1]
+- Fuente Vo IoCom Modulo; +- Sensor
