hhautomatizacion/sec-challenge/Diagramas/Plantilla Secadora CHALLENGE.pdf

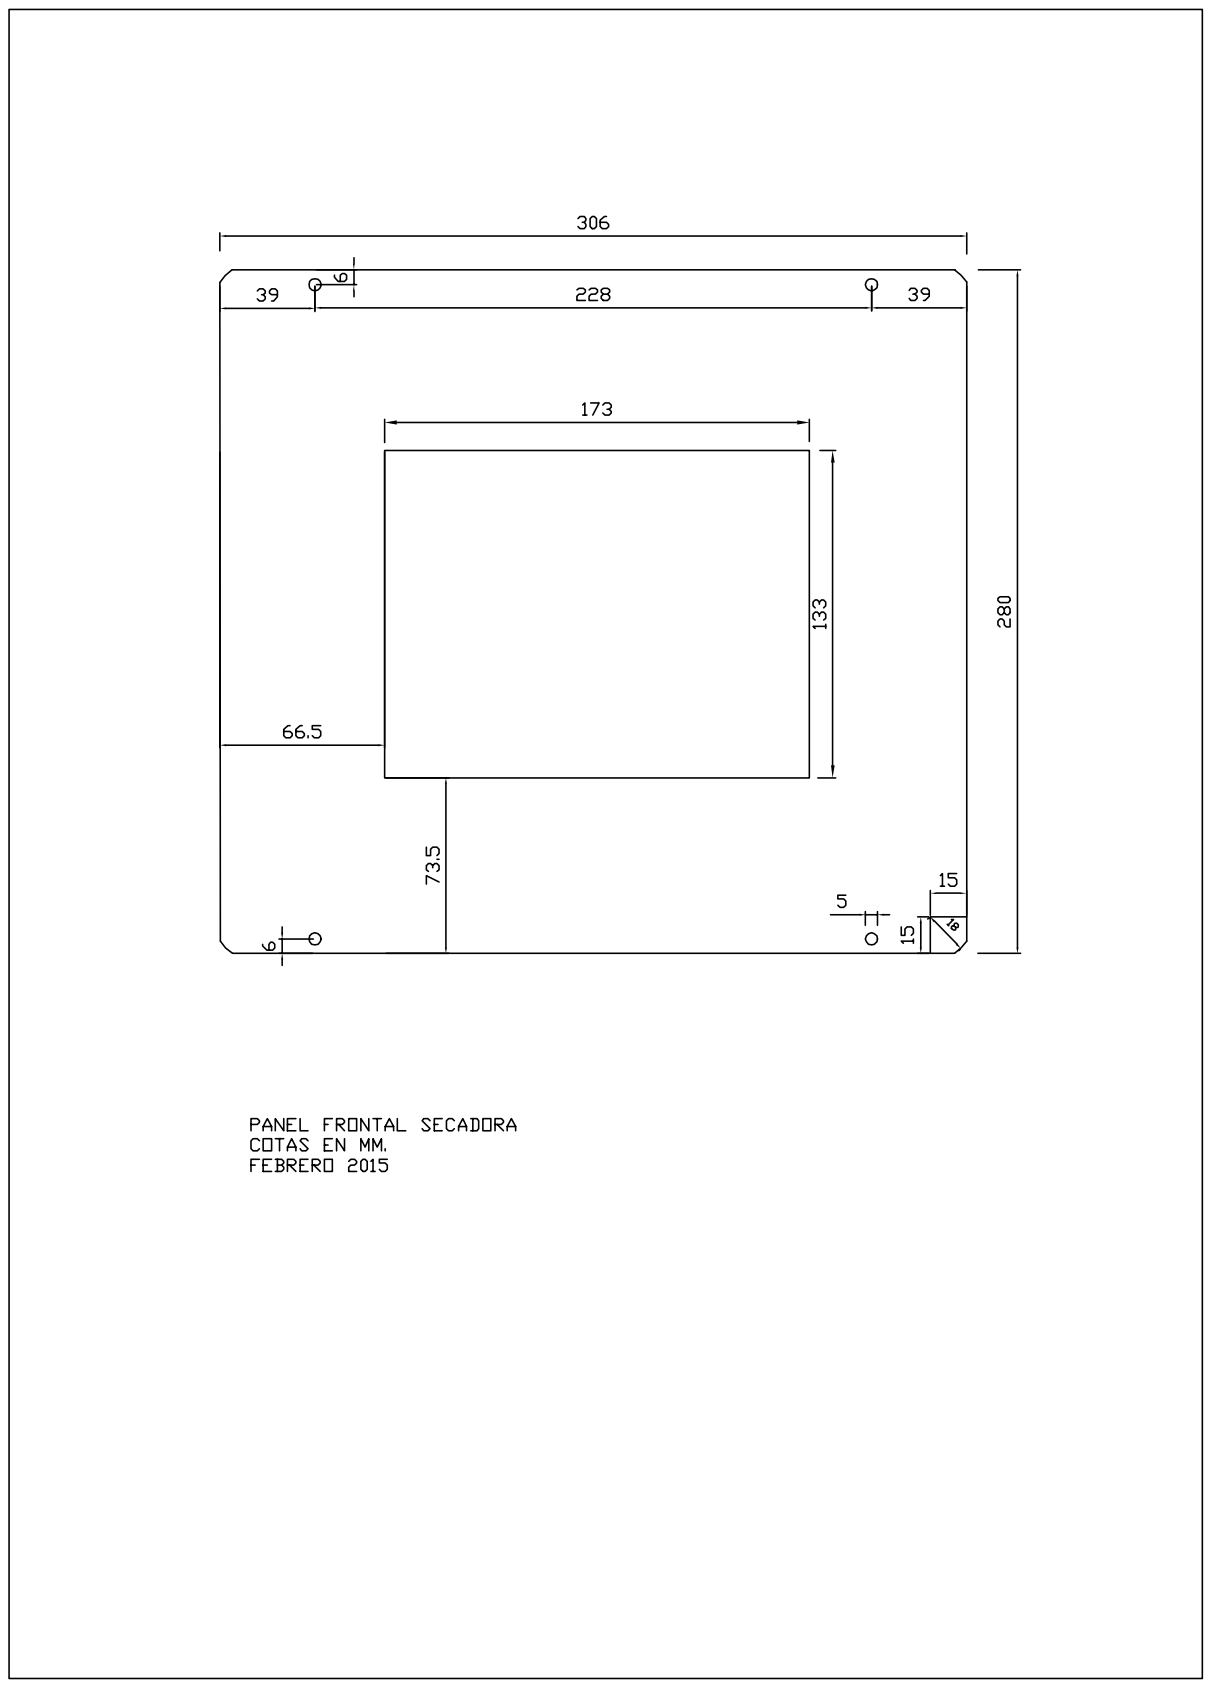
[picture p58: page 1]
