hhautomatizacion/sec-challenge/(commit log)

2015-10-10 Commit inicial
    [SEC 17 2015-03-22 14.38.17.xlsx, SEC 17 2015-03-23 07.04.18.xlsx, conversion adc.xlsx, entradas y salidas.xlsx, estructura paso.xlsx, parametros.xlsx, sec 17 2015-03-18 11.08.58.xlsx, sec 17 2015-03-19 12.16.36.xlsx]
2015-10-13 Se agrega pantalla para configurar la conversion analogo digital. Se agrega pantalla para activar componentes adicionales. Se mejora presentacion en varias pantallas.
    [conversion adc.xlsx]
2015-10-26 Se agrega lista de parametros por default.
    [entradas y salidas.xlsx, parametros.xlsx]
2015-10-27 Ajuste 4mamp en salida de PLC hacia modutrol.
2015-11-23 Se libera nueva version sin numero.
    [estructura paso.xlsx]
2015-11-29 Se libera version 1.01 de PLC y 1.01 de HMI.
    * Se corrige issue #2 (reset de fireye)
    * Se corrige issue #3 (limite temp alta)
    * Se corrige issue #4 (saltar a paso vacio)
    Se corrige enfriemiento no brinca al estar debajo de temperatura programada.
    Se corrige error no mostraba correcto el tiempo en reposo de la maquina.
2016-01-19 Se libera version 1.02 de PLC y 1.02 de HMI.
    * Se corrige #6, conversor de word a minutossegundos.
    * Se corrige #7, al iniciar formula con puertas abiertas o en posicion no horizontal muestra pantalla para corregir o cancelar. Al corregir se inicia la formula como si nada hubiera pasado.
    * Se crea manual de usuario #8.
    * Se corrige #9, mensaje error temperatura pelucero.
    * Se corrige #10, paro de emergencia permite cancelar o reanudar.
    * Se corrige #11, termico de canasta permite salir solo cuando el termico esta reestablecido.
    * Se corrige #12, maq. no horizontal permite salir solo cuando el problema esta corregido.
    * Se corrige #16, permitir salir de pantalla de fallas solo cuando el probl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
2016-04-16 Se agrega programa de PLC con prueba de autotunning.
2016-04-17 Se libera version 1.03 de PLC y 1.03 de HMI. * Se implementa #1, memoria en caso de perdida de energia. * Se corrige #13, P09 (vacio ventilador principal) no incluido en la seguridades. * Se corrige 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
    [estructura paso.xlsx, pid secadora challenge.xlsx]
2016-11-24 Se le agrega configuracion de entradas analogas CH0, CH1 a corriente. Se corrige esquematico de salidas en una sola pagina.
    [Modificacion secadora CHALLENGE.dwg]
2017-01-10 Se agrega manual de usuario en PDF
2017-01-21 Se agrega ventana de falla en valvula de gas no abre. (#15)
    [SEC 17 2015-03-23 07.04.18.xlsx, sec 17 2015-03-18 11.08.58.xlsx, sec 17 2015-03-19 12.16.36.xlsx, sec 17 2015-03-20 14.30.05.xlsx, sec 17 2015-03-21 09.12.41.xlsx, texto.xlsx]
2017-03-16 Actualizado marzo 2017 Uso de pantalla HMI de 7 pulgadas.
    [Modificacion secadora CHALLENGE.dwg]
2018-02-09 Se reorganizan archivos para diferentes versiones de HMI.
    [codigo ascii.xls, parametros.xlsx]
2020-11-20 Se libera version 1.04 de PLC y 1.04 de HMI
    [estructura paso.xlsx, texto.xlsx]
2021-03-27 Se llibera version 1.05 de hmi y de plc
    [sensor humedad.dwg]
2021-04-02 Se agrega descripcion de mejora con sensor de humedad
